buildwithnoknok/module-I2C-picohub-MOD-0011/hardware/MOD-0011-schematic.pdf

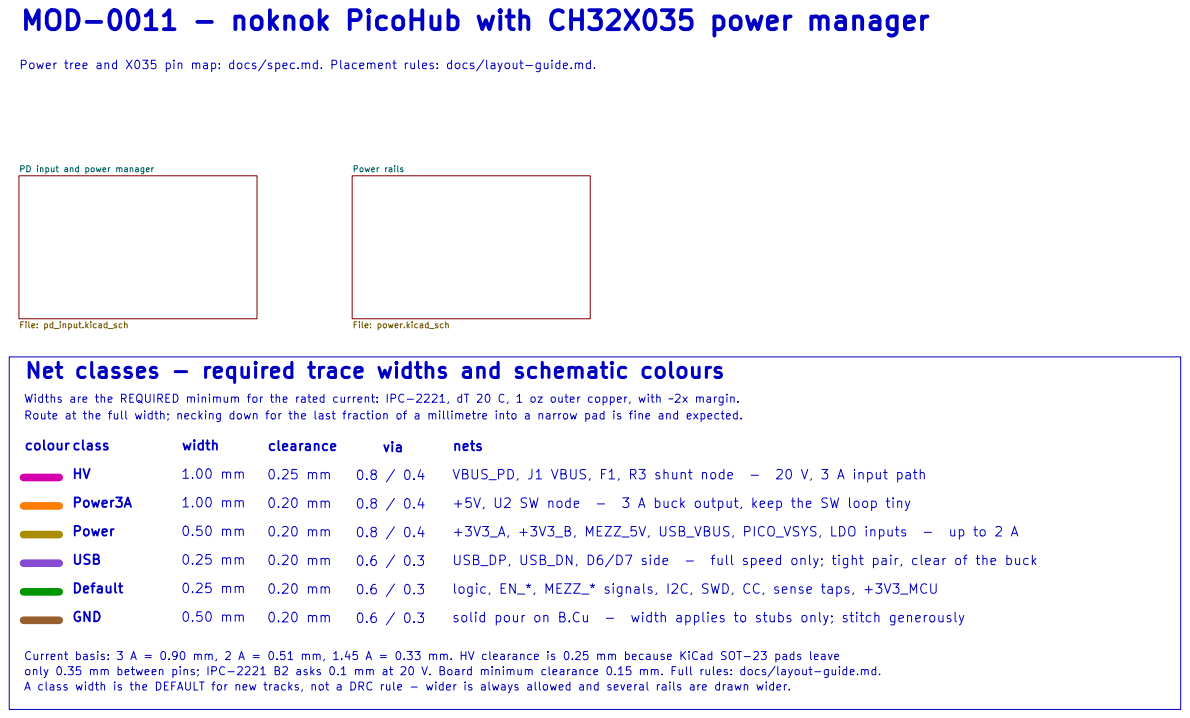
[picture p1: page 1]

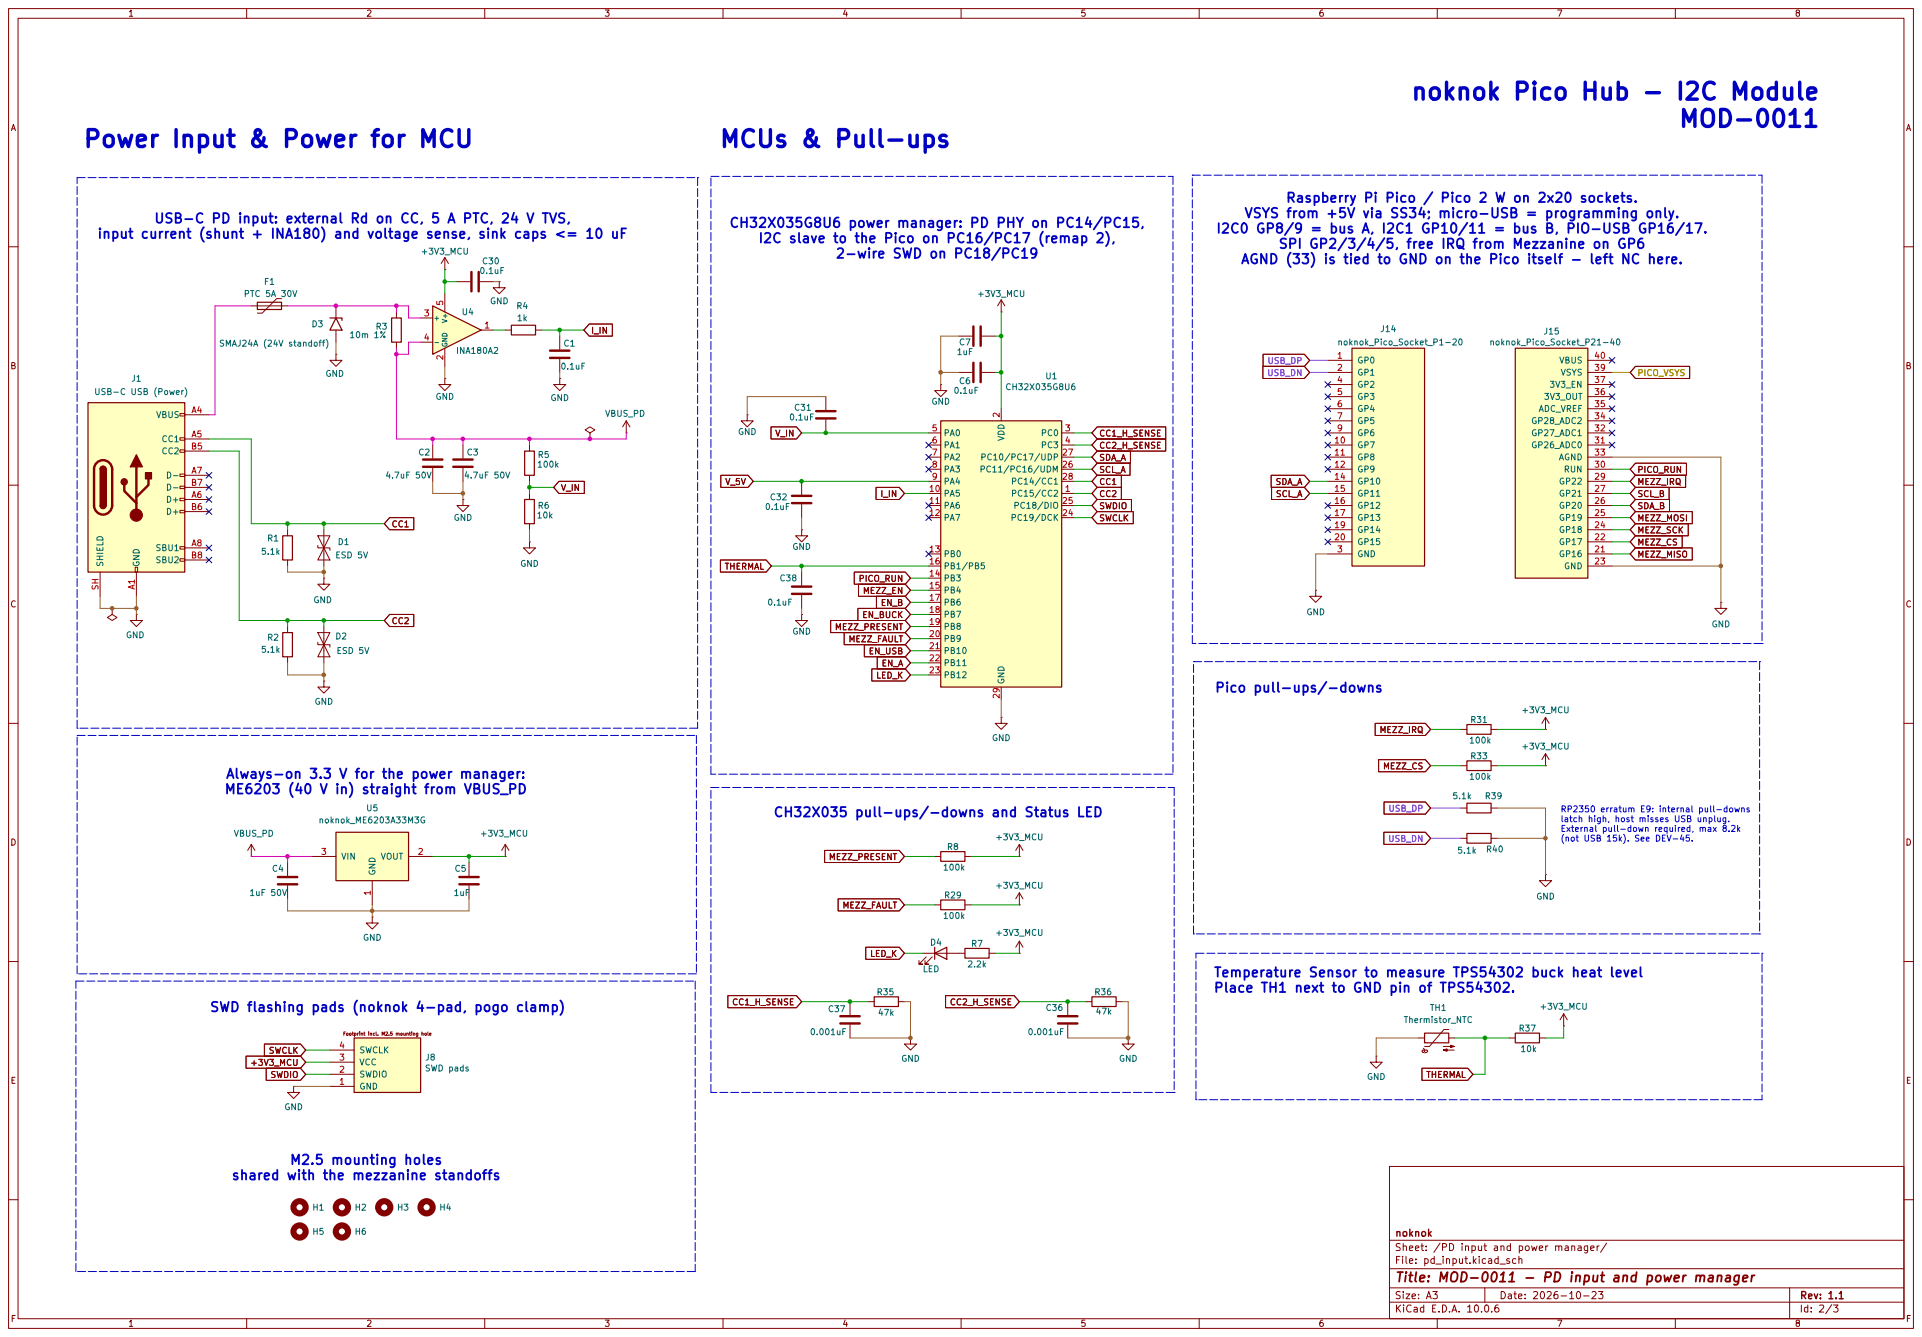
[picture p2: page 2]

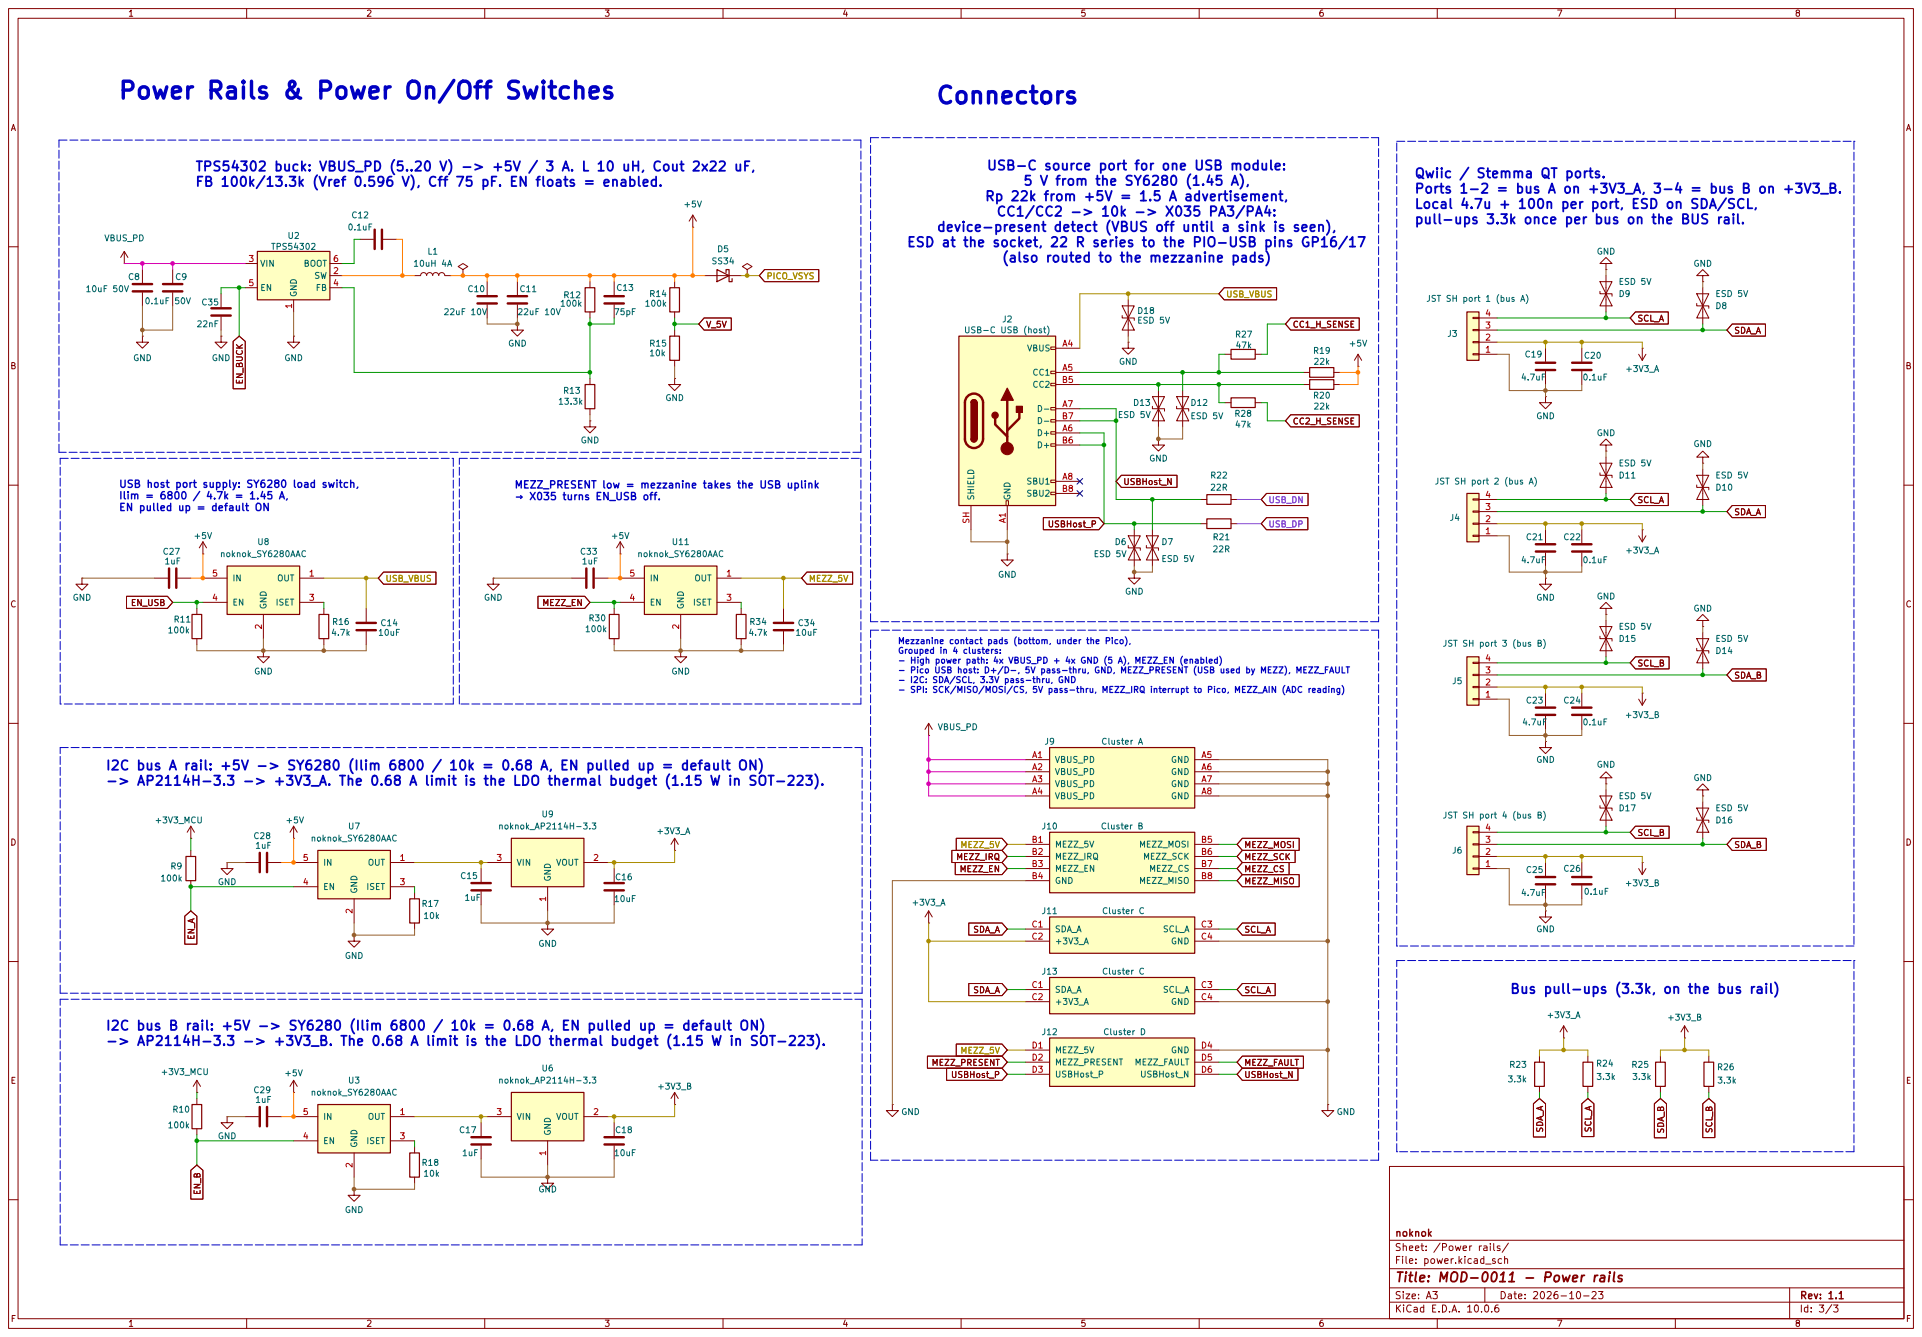
[picture p3: page 3]
