buildwithnoknok/module-I2C-picohub-MOD-0011/hardware/kicad/MOD-0011.kicad_pcb

## KiCad design hardware/kicad/MOD-0011.kicad_pcb (2026-10-23)

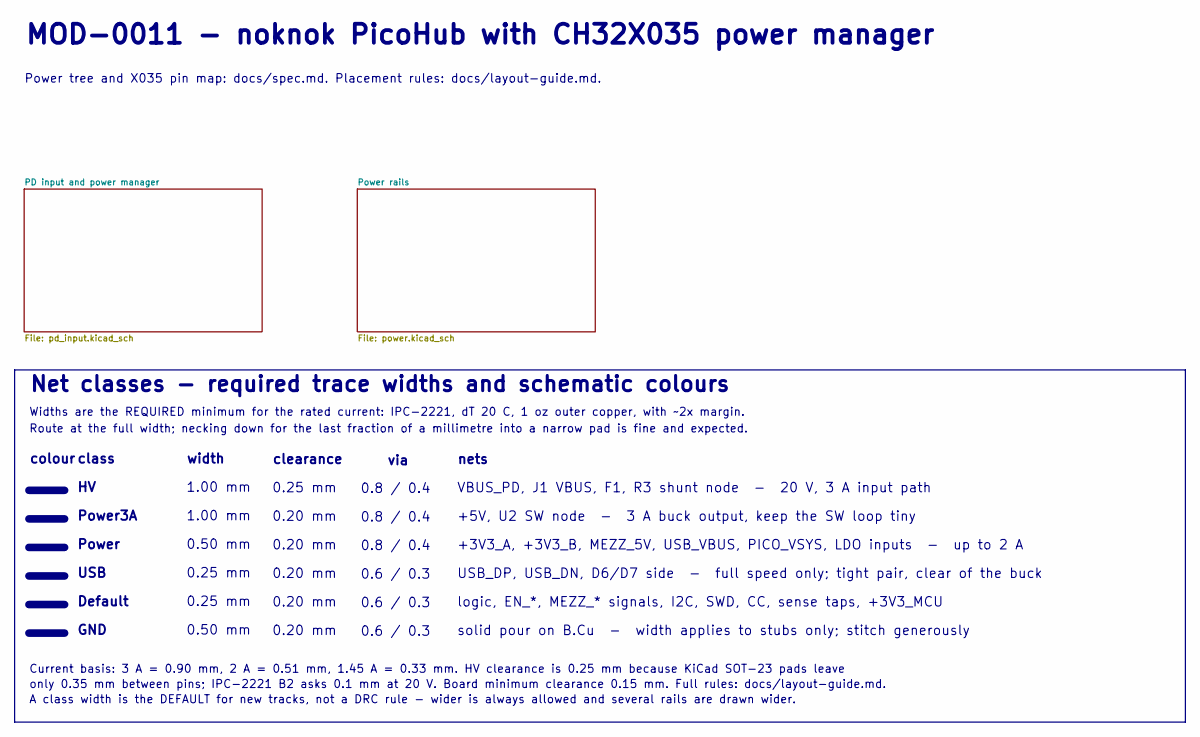
[picture p4: schematic MOD-0011.kicad_sch, MOD-0011 - noknok PicoHub]

Notes on the sheet:
Current basis: 3 A = 0.90 mm, 2 A = 0.51 mm, 1.45 A = 0.33 mm. HV clearance is 0.25 mm because KiCad SOT-23 pads leave
width
Power tree and X035 pin map: docs/spec.md. Placement rules: docs/layout-guide.md.
Net classes - required trace widths and schematic colours
USB
0.6 / 0.3
GND
USB_DP, USB_DN, D6/D7 side - full speed only; tight pair, clear of the buck
solid pour on B.Cu - width applies to stubs only; stitch generously
0.20 mm
class
+5V, U2 SW node - 3 A buck output, keep the SW loop tiny
1.00 mm
Default
A class width is the DEFAULT for new tracks, not a DRC rule - wider is always allowed and several rails are drawn wider.
VBUS_PD, J1 VBUS, F1, R3 shunt node - 20 V, 3 A input path
0.50 mm
0.25 mm
MOD-0011 - noknok PicoHub with CH32X035 power manager
clearance
via
+3V3_A, +3V3_B, MEZZ_5V, USB_VBUS, PICO_VSYS, LDO inputs - up to 2 A
0.8 / 0.4
colour
logic, EN_*, MEZZ_* signals, I2C, SWD, CC, sense taps, +3V3_MCU
Power3A
nets
only 0.35 mm between pins; IPC-2221 B2 asks 0.1 mm at 20 V. Board minimum clearance 0.15 mm. Full rules: docs/layout-guide.md.
Widths are the REQUIRED minimum for the rated current: IPC-2221, dT 20 C, 1 oz outer copper, with ~2x margin.
Power
Route at the full width; necking down for the last fraction of a millimetre into a narrow pad is fine and expected.

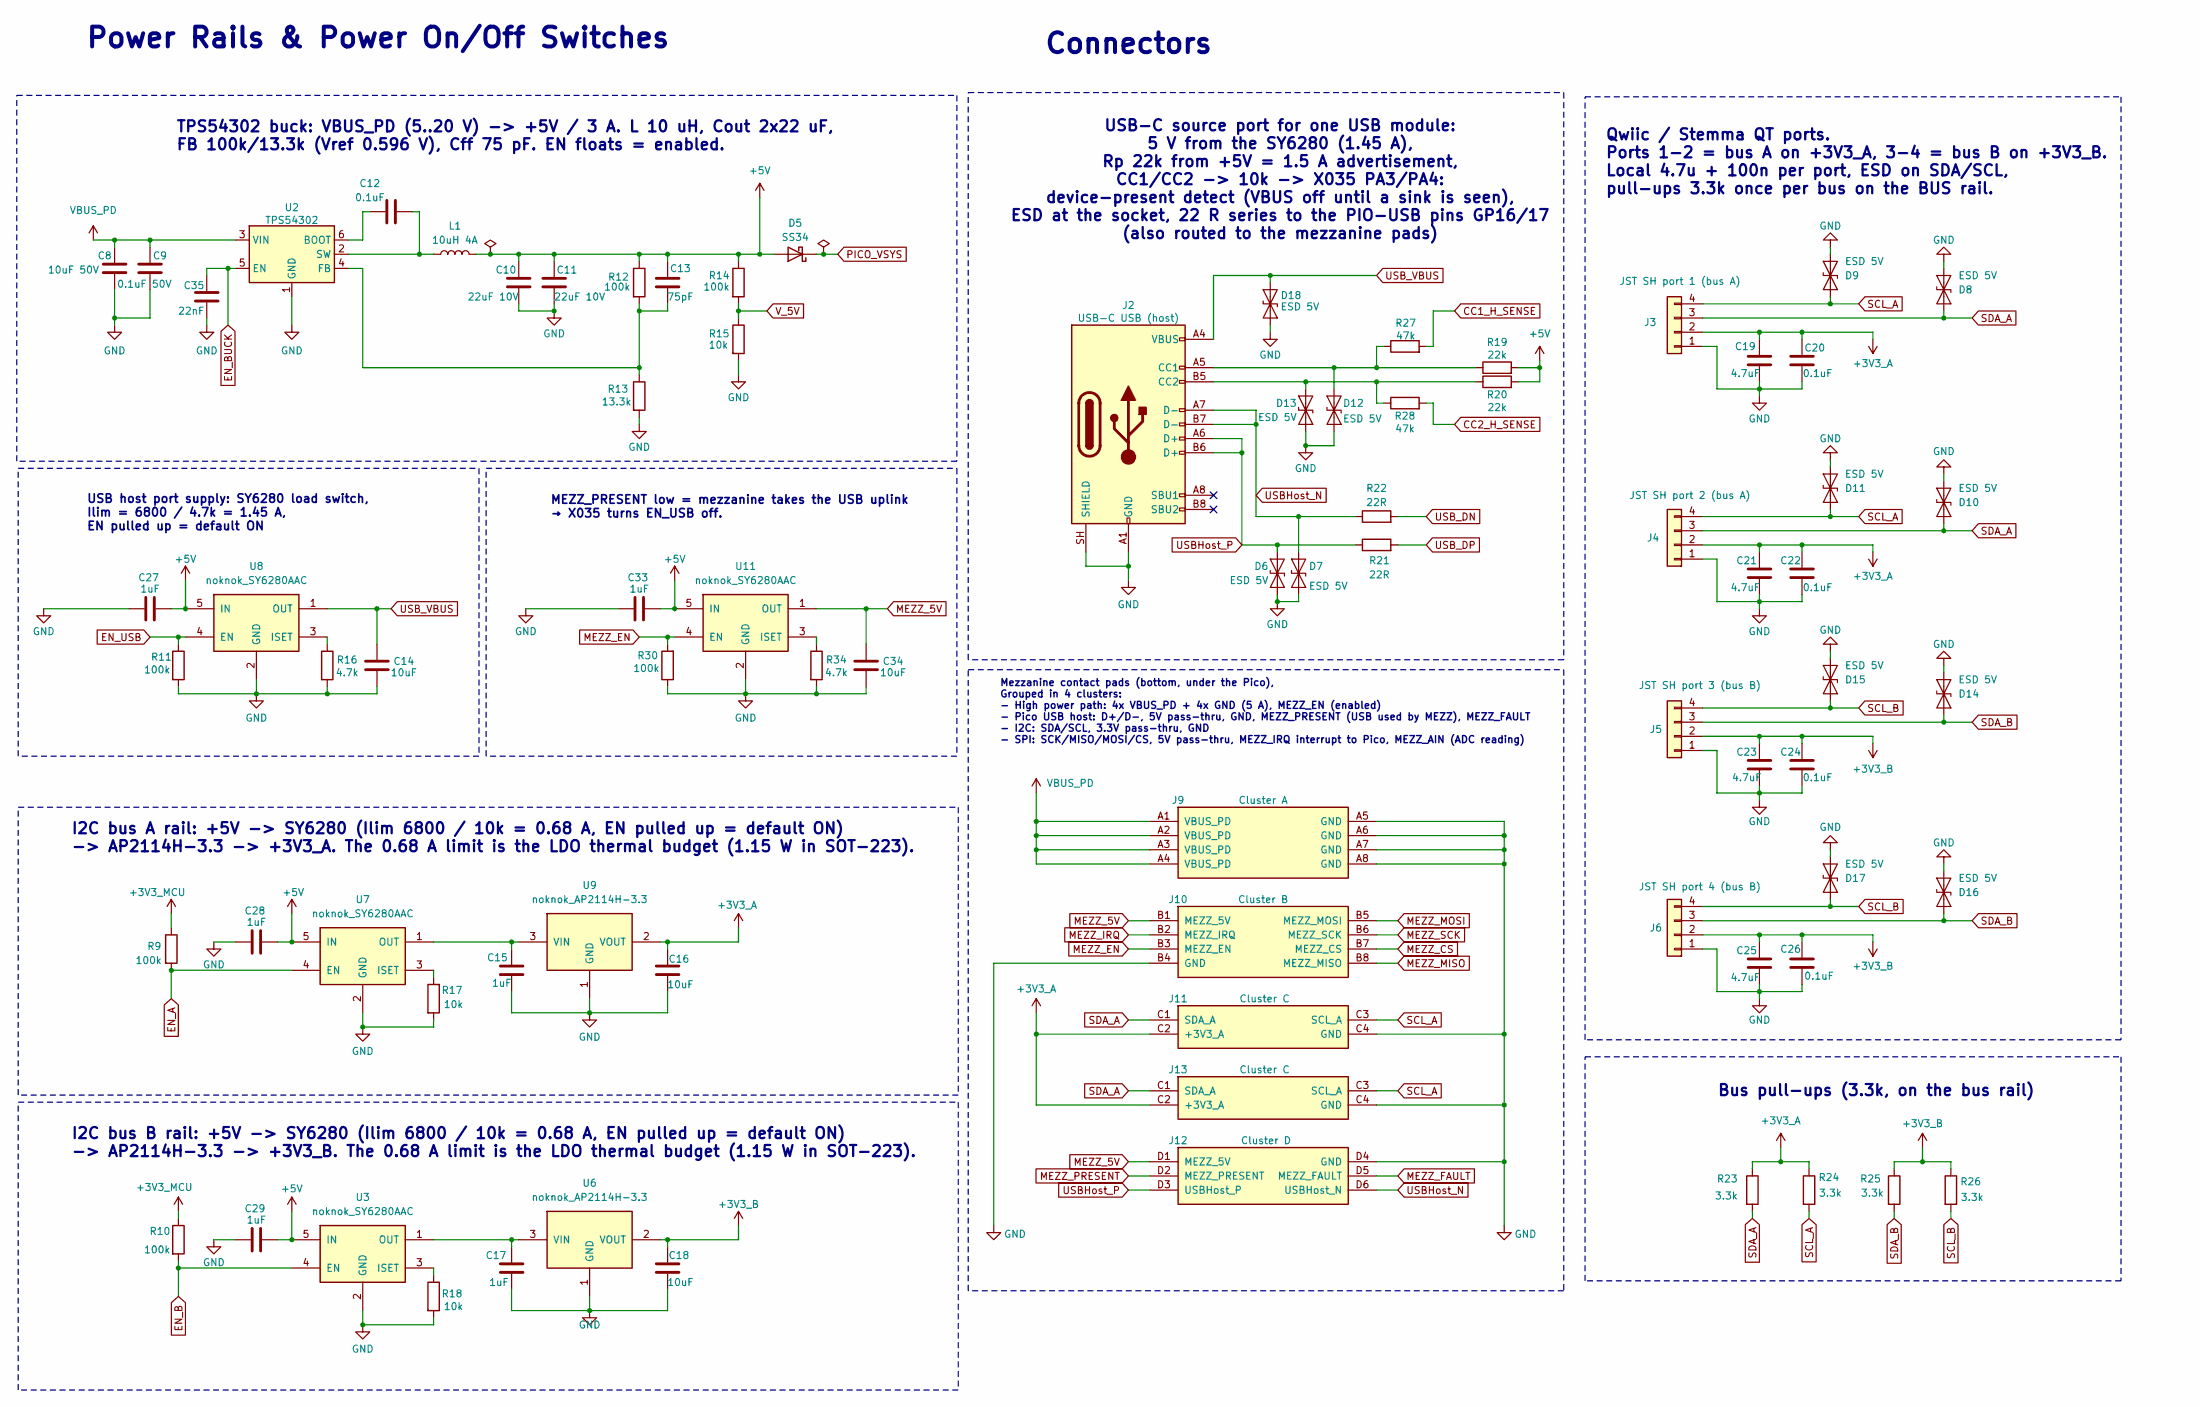
[picture p5: schematic power.kicad_sch, MOD-0011 - Power rails]

Parts:
C8: 10uF 50V; C_1210_3225Metric; LCSC Part # C138687
C9: 0.1uF 50V; C_0603_1608Metric; LCSC Part # C14663
C10, C11: 22uF 10V; C_0805_2012Metric; LCSC Part # C29277
C12, C20, C22, C24, C26: 0.1uF; C_0603_1608Metric; LCSC Part # C14663
C13: 75pF; C_0603_1608Metric; LCSC Part # C1681
C14, C16, C18, C34: 10uF; C_0805_2012Metric; LCSC Part # C15850
C15, C17, C27, C28, C29, C33: 1uF; C_0603_1608Metric; LCSC Part # C5199872
C19, C21, C23, C25: 4.7uF; C_0805_2012Metric; LCSC Part # C1779
C35: 22nF; C_0603_1608Metric; LCSC Part # C21122
D5: SS34; D_SMA; LCSC Part # C8678
D6, D7, D8, D9, D10, D11, D12, D13, D14, D15, D16, D17, D18: ESD 5V; D_SOD-923; LCSC Part # C111566
J2: USB-C USB (host); USB_C_Receptacle_HRO_TYPE-C-31-M-12; LCSC Part # C165948
J3: JST SH port 1 (bus A); JST_SH_SM04B-SRSS-TB_1x04-1MP_P1.00mm_Horizontal; LCSC Part # C160404
J4: JST SH port 2 (bus A); JST_SH_SM04B-SRSS-TB_1x04-1MP_P1.00mm_Horizontal; LCSC Part # C160404
J5: JST SH port 3 (bus B); JST_SH_SM04B-SRSS-TB_1x04-1MP_P1.00mm_Horizontal; LCSC Part # C160404
J6: JST SH port 4 (bus B); JST_SH_SM04B-SRSS-TB_1x04-1MP_P1.00mm_Horizontal; LCSC Part # C160404
J9: Cluster A; noknok_Mezzanine_A_Pads_M2.5
J10: Cluster B; noknok_Mezzanine_B_Pads_M2.5
J11, J13: Cluster C; noknok_Mezzanine_C_Pads_M2.5
J12: Cluster D; noknok_Mezzanine_D_Pads_M2.5
L1: 10uH 4A; L_Chilisin_BMRx00060630; LCSC Part # C2981193
R9, R10, R11, R12, R14, R30: 100k; R_0603_1608Metric; LCSC Part # C25803
R13: 13.3k; R_0603_1608Metric; LCSC Part # C25952
R15, R17, R18: 10k; R_0603_1608Metric; LCSC Part # C25804
R16, R34: 4.7k; R_0603_1608Metric; LCSC Part # C23162
R19, R20: 22k; R_0603_1608Metric; LCSC Part # C31850
R21, R22: 22R; R_0603_1608Metric; LCSC Part # C23345
R23, R24, R25, R26: 3.3k; R_0603_1608Metric; LCSC Part # C22978
R27, R28: 47k; R_0603_1608Metric; LCSC Part # C25819
U2: TPS54302; TSOT-23-6; LCSC Part # C311983
U3, U7, U8, U11: noknok_SY6280AAC; SOT-23-5; LCSC Part # C55136
U6, U9: noknok_AP2114H-3.3; SOT-223-3_TabPin2; LCSC Part # C150716

Connections:
+3V3_A: C16.1, C19.1, C20.1, C21.1, C22.1, J3.2, J4.2, J11.C2 (+3V3_A), J13.C2 (+3V3_A), R23.1, R24.1, U9.2 (VOUT)
+3V3_B: C18.1, C23.1, C24.1, C25.1, C26.1, J5.2, J6.2, R25.1, R26.1, U6.2 (VOUT)
+3V3_MCU: R9.1, R10.1; also elsewhere on the board
CC1_H_SENSE: R27.2; also elsewhere on the board
CC2_H_SENSE: R28.2; also elsewhere on the board
EN_A: R9.2, U7.4 (EN); also elsewhere on the board
EN_B: R10.2, U3.4 (EN); also elsewhere on the board
EN_BUCK: C35.1, U2.5 (EN); also elsewhere on the board
EN_USB: R11.1, U8.4 (EN); also elsewhere on the board
MEZZ_5V: C34.2, J10.B1 (MEZZ_5V), J12.D1 (MEZZ_5V), U11.1 (OUT)
MEZZ_CS: J10.B7 (MEZZ_CS); also elsewhere on the board
MEZZ_EN: J10.B3 (MEZZ_EN), R30.2, U11.4 (EN); also elsewhere on the board
MEZZ_FAULT: J12.D5 (MEZZ_FAULT); also elsewhere on the board
MEZZ_IRQ: J10.B2 (MEZZ_IRQ); also elsewhere on the board
MEZZ_MISO: J10.B8 (MEZZ_MISO); also elsewhere on the board
MEZZ_MOSI: J10.B5 (MEZZ_MOSI); also elsewhere on the board
MEZZ_PRESENT: J12.D2 (MEZZ_PRESENT); also elsewhere on the board
MEZZ_SCK: J10.B6 (MEZZ_SCK); also elsewhere on the board
unnamed: D12.1 (A1), J2.A5 (CC1), R19.1, R27.1
unnamed: D13.1 (A1), J2.B5 (CC2), R20.1, R28.1
unnamed: C12.1, U2.6 (BOOT)
unnamed: C13.2, R12.2, R13.1, U2.4 (FB)
unnamed: C12.2, L1.1, U2.2 (SW)
unnamed: R18.1, U3.3 (ISET)
unnamed: C17.1, U3.1 (OUT), U6.3 (VIN)
unnamed: R17.1, U7.3 (ISET)
unnamed: C15.1, U7.1 (OUT), U9.3 (VIN)
unnamed: R16.1, U8.3 (ISET)
unnamed: R34.1, U11.3 (ISET)
SCL_A: D9.1 (A1), D11.1 (A1), J3.4, J4.4, J11.C3 (SCL_A), J13.C3 (SCL_A), R24.2; also elsewhere on the board
SCL_B: D15.1 (A1), D17.1 (A1), J5.4, J6.4, R26.2; also elsewhere on the board
SDA_A: D8.1 (A1), D10.1 (A1), J3.3, J4.3, J11.C1 (SDA_A), J13.C1 (SDA_A), R23.2; also elsewhere on the board
SDA_B: D14.1 (A1), D16.1 (A1), J5.3, J6.3, R25.2; also elsewhere on the board
USBHost_N: D7.1 (A1), J2.A7 (D-), J2.B7 (D-), J12.D6 (USBHost_N), R22.1
USBHost_P: D6.1 (A1), J2.A6 (D+), J2.B6 (D+), J12.D3 (USBHost_P), R21.1
USB_DN: R22.2; also elsewhere on the board
USB_DP: R21.2; also elsewhere on the board
USB_VBUS: C14.2, D18.1 (A1), J2.A4 (VBUS), J2.A9 (VBUS), J2.B4 (VBUS), J2.B9 (VBUS), U8.1 (OUT)
V_5V: R14.2, R15.1; also elsewhere on the board

Notes on the sheet:
Connectors
TPS54302 buck: VBUS_PD (5..20 V) -> +5V / 3 A. L 10 uH, Cout 2x22 uF, FB 100k/13.3k (Vref 0.596 V), Cff 75 pF. EN floats = enabled.
Qwiic / Stemma QT ports. Ports 1-2 = bus A on +3V3_A, 3-4 = bus B on +3V3_B. Local 4.7u + 100n per port, ESD on SDA/SCL, pull-ups 3.3k once per bus on the BUS rail.
I2C bus A rail: +5V -> SY6280 (Ilim 6800 / 10k = 0.68 A, EN pulled up = default ON) -> AP2114H-3.3 -> +3V3_A. The 0.68 A limit is the LDO thermal budget (1.15 W in SOT-223).
USB-C source port for one USB module: 5 V from the SY6280 (1.45 A), Rp 22k from +5V = 1.5 A advertisement, CC1/CC2 -> 10k -> X035 PA3/PA4: device-present detect (VBUS off until a sink is seen), ESD at the socket, 22 R series to the PIO-USB pins GP16/17 (also routed to the mezzanine pads)
USB host port supply: SY6280 load switch, Ilim = 6800 / 4.7k = 1.45 A, EN pulled up = default ON
Power Rails & Power On/Off Switches
Bus pull-ups (3.3k, on the bus rail)
MEZZ_PRESENT low = mezzanine takes the USB uplink → X035 turns EN_USB off.
Mezzanine contact pads (bottom, under the Pico), Grouped in 4 clusters: - High power path: 4x VBUS_PD + 4x GND (5 A), MEZZ_EN (enabled) - Pico USB host: D+/D-, 5V pass-thru, GND, MEZZ_PRESENT (USB used by MEZZ), MEZZ_FAULT - I2C: SDA/SCL, 3.3V pass-thru, GND - SPI: SCK/MISO/MOSI/CS, 5V pass-thru, M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
I2C bus B rail: +5V -> SY6280 (Ilim 6800 / 10k = 0.68 A, EN pulled up = default ON) -> AP2114H-3.3 -> +3V3_B. The 0.68 A limit is the LDO thermal budget (1.15 W in SOT-223).

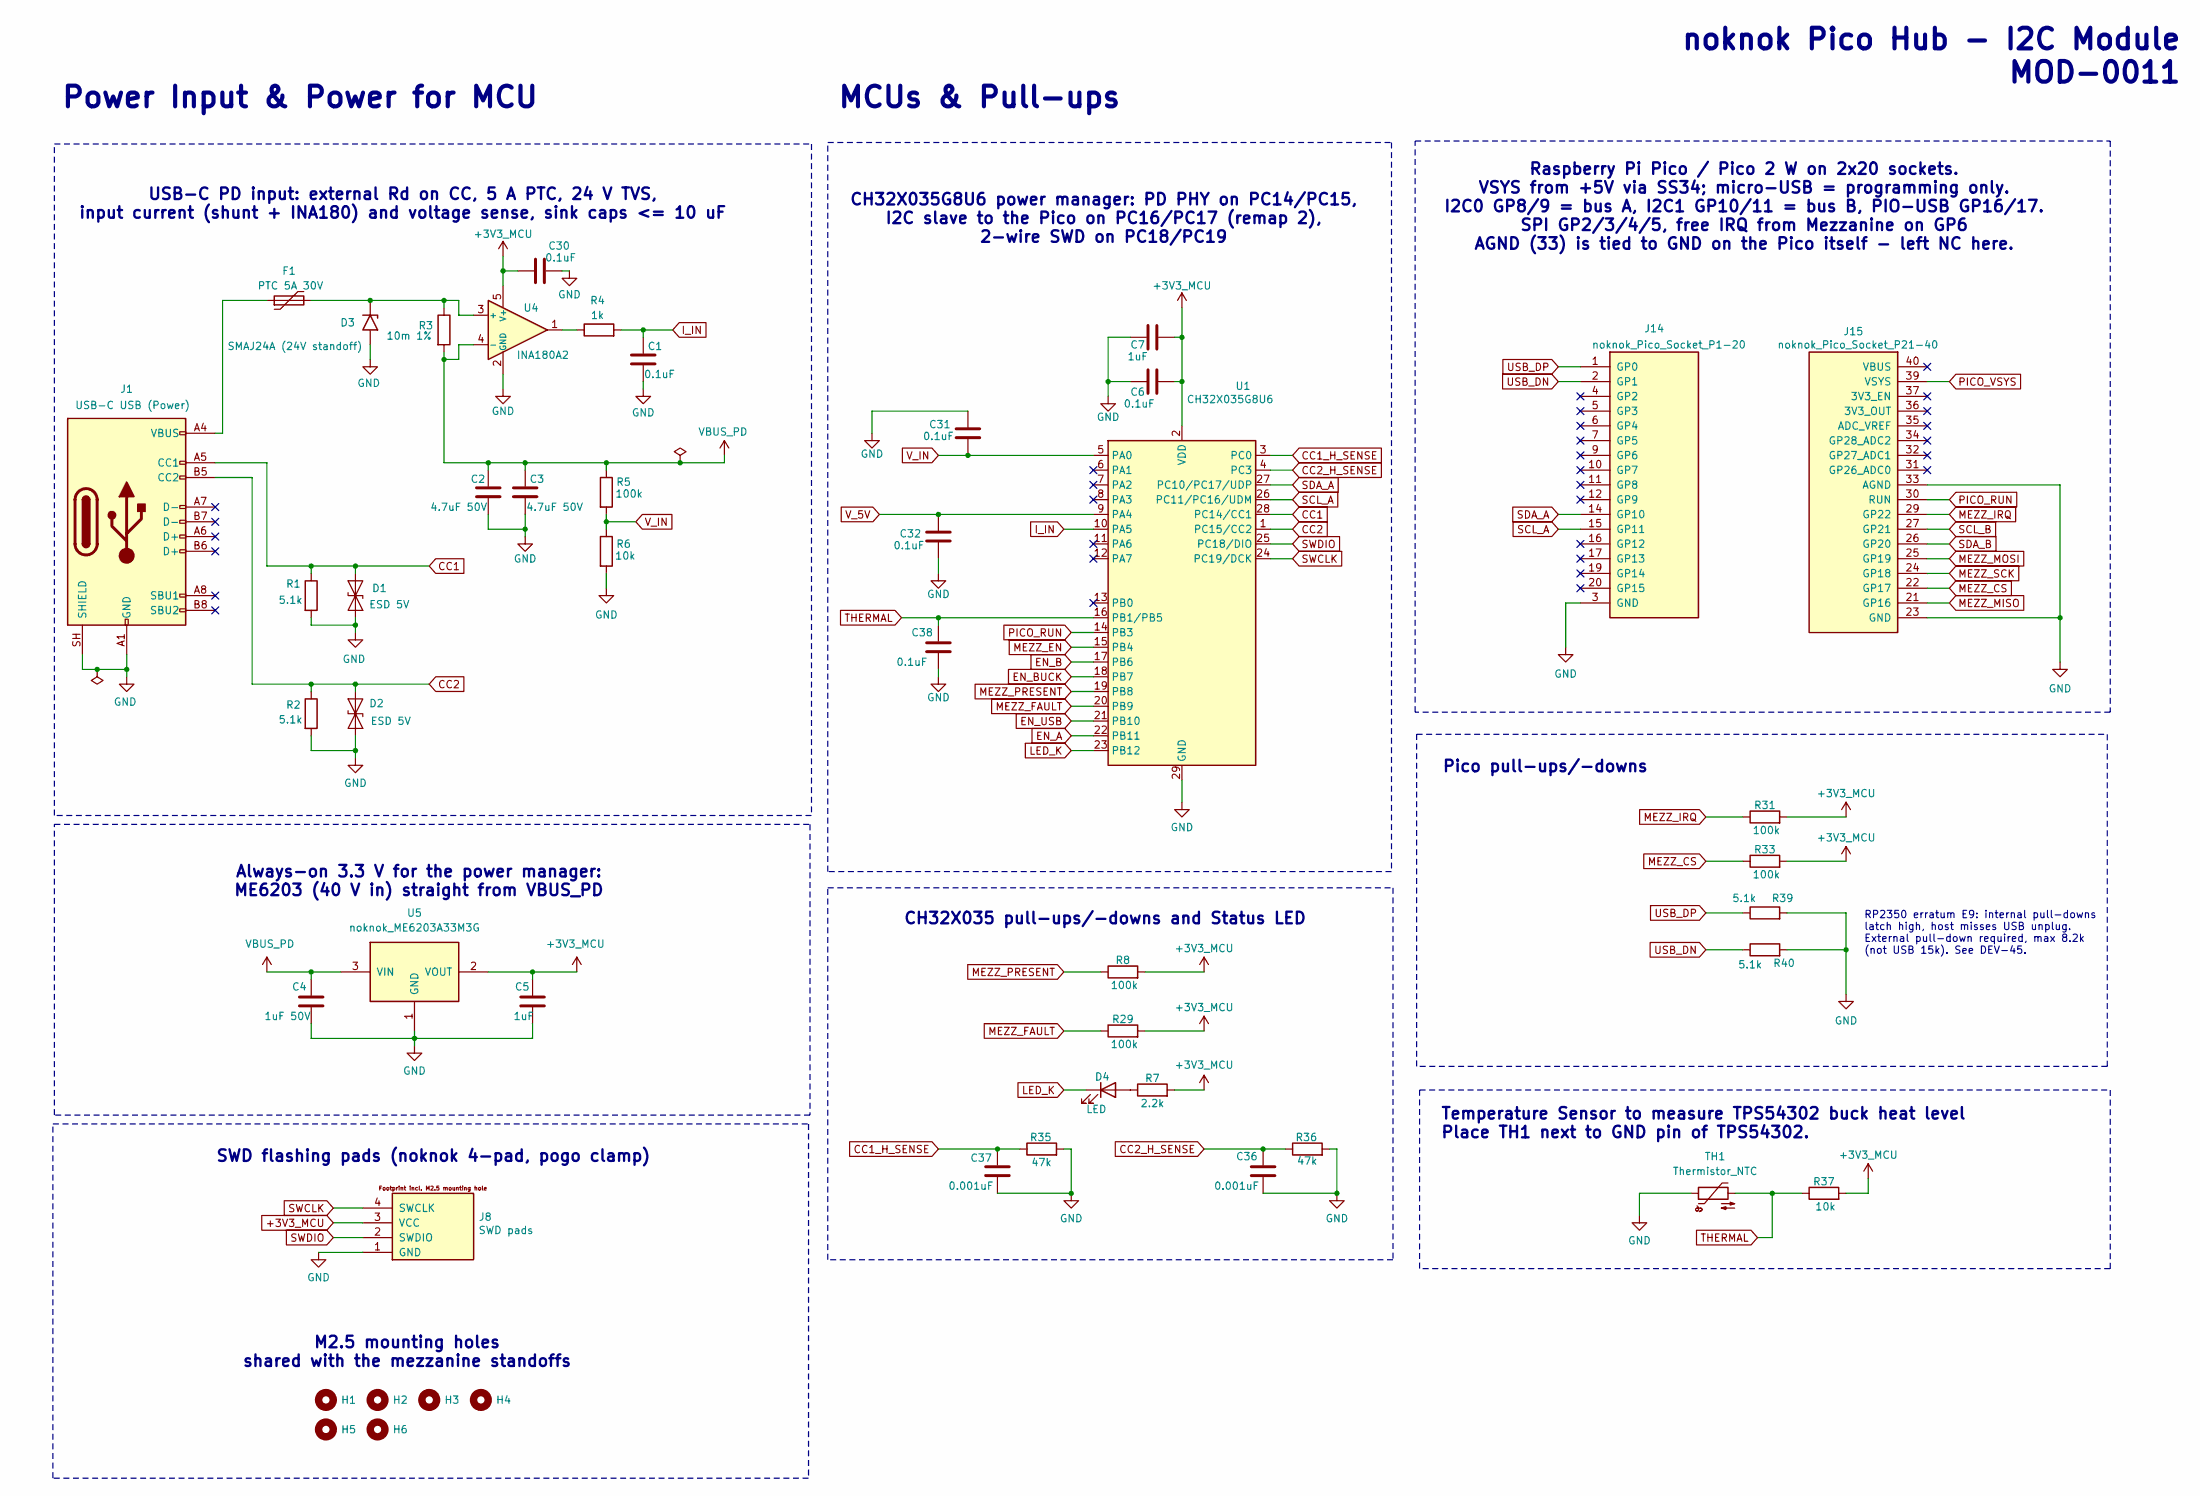
[picture p6: schematic pd_input.kicad_sch, MOD-0011 - PD input and power manager]

Parts:
C1, C6, C30, C31, C32, C38: 0.1uF; C_0603_1608Metric; LCSC Part # C14663
C2, C3: 4.7uF 50V; C_1206_3216Metric; LCSC Part # C51205
C4: 1uF 50V; C_0603_1608Metric; LCSC Part # C5199872
C5, C7: 1uF; C_0603_1608Metric; LCSC Part # C5199872
C36, C37: 0.001uF; C_0603_1608Metric; LCSC Part # C1588
D1, D2: ESD 5V; D_SOD-923; LCSC Part # C111566
D3: SMAJ24A (24V standoff); D_SMA; LCSC Part # C908774
D4: LED; LED_0603_1608Metric; LCSC Part # C2286
F1: PTC 5A 30V; Fuse_2920_7451Metric; LCSC Part # C19078763
H1, H2, H3, H4, H5, H6: noknok_MountingHole; noknok_MountingHole_2.5mm_M2.5
J1: USB-C USB (Power); USB_C_Receptacle_HRO_TYPE-C-31-M-12; LCSC Part # C165948
J8: SWD pads; noknok_FlashPads_USB-module_1x4_M2.5
J14: noknok_Pico_Socket_P1-20; noknok_Pico_Socket_P1-20_THT; LCSC Part # C7509519
J15: noknok_Pico_Socket_P21-40; noknok_Pico_Socket_P21-40_THT; LCSC Part # C7509519
R1, R2: 5.1k; R_0603_1608Metric; LCSC Part # C23186
R3: 10m 1%; R_2512_6332Metric; LCSC Part # C46634450
R4: 1k; R_0603_1608Metric; LCSC Part # C21190
R5, R8, R29, R31, R33: 100k; R_0603_1608Metric; LCSC Part # C25803
R6, R37: 10k; R_0603_1608Metric; LCSC Part # C25804
R7: 2.2k; R_0603_1608Metric; LCSC Part # C4190
R35, R36: 47k; R_0603_1608Metric; LCSC Part # C25819
R39, R40: 5.1k; R_0603_1608Metric; LCSC Part # C21190
TH1: Thermistor_NTC; R_0603_1608Metric; LCSC Part # C2892547
U1: CH32X035G8U6; WQFN-28-1EP_4x4mm_P0.4mm_EP2.7x2.7mm; LCSC Part # C7437027
U4: INA180A2; SOT-23-5; LCSC Part # C192764
U5: noknok_ME6203A33M3G; SOT-23; LCSC Part # C87842

Connections:
+3V3_MCU: C5.1, C6.2, C7.2, C30.1, J8.3 (VCC), R7.2, R8.2, R29.2, R31.2, R33.2, R37.2, U1.2 (VDD), U4.5 (V+), U5.2 (VOUT); also elsewhere on the board
CC1: D1.1 (A1), J1.A5 (CC1), R1.1, U1.28 (PC14/CC1)
CC1_H_SENSE: C37.1, R35.1, U1.3 (PC0); also elsewhere on the board
CC2: D2.1 (A1), J1.B5 (CC2), R2.1, U1.1 (PC15/CC2)
CC2_H_SENSE: C36.1, R36.1, U1.4 (PC3); also elsewhere on the board
EN_A: U1.22 (PB11); also elsewhere on the board
EN_B: U1.17 (PB6); also elsewhere on the board
EN_BUCK: U1.18 (PB7); also elsewhere on the board
EN_USB: U1.21 (PB10); also elsewhere on the board
I_IN: C1.1, R4.2, U1.10 (PA5)
LED_K: D4.1 (K), U1.23 (PB12)
MEZZ_CS: J15.22 (GP17), R33.1; also elsewhere on the board
MEZZ_EN: U1.15 (PB4); also elsewhere on the board
MEZZ_FAULT: R29.1, U1.20 (PB9); also elsewhere on the board
MEZZ_IRQ: J15.29 (GP22), R31.1; also elsewhere on the board
MEZZ_MISO: J15.21 (GP16); also elsewhere on the board
MEZZ_MOSI: J15.25 (GP19); also elsewhere on the board
MEZZ_PRESENT: R8.1, U1.19 (PB8); also elsewhere on the board
MEZZ_SCK: J15.24 (GP18); also elsewhere on the board
unnamed: D3.1 (A1), F1.2, R3.1, U4.3 (+)
unnamed: D4.2 (A), R7.1
unnamed: F1.1, J1.A4 (VBUS), J1.A9 (VBUS), J1.B4 (VBUS), J1.B9 (VBUS)
unnamed: R4.1, U4.1
PICO_RUN: J15.30 (RUN), U1.14 (PB3)
SCL_A: J14.15 (GP11), U1.26 (PC11/PC16/UDM); also elsewhere on the board
SCL_B: J15.27 (GP21); also elsewhere on the board
SDA_A: J14.14 (GP10), U1.27 (PC10/PC17/UDP); also elsewhere on the board
SDA_B: J15.26 (GP20); also elsewhere on the board
SWCLK: J8.4 (SWCLK), U1.24 (PC19/DCK)
SWDIO: J8.2 (SWDIO), U1.25 (PC18/DIO)
THERMAL: C38.1, R37.1, TH1.2, U1.16 (PB1/PB5)
USB_DN: J14.2 (GP1), R40.1; also elsewhere on the board
USB_DP: J14.1 (GP0), R39.1; also elsewhere on the board
V_5V: C32.2, U1.9 (PA4); also elsewhere on the board
V_IN: C31.1, R5.2, R6.1, U1.5 (PA0)

Notes on the sheet:
RP2350 erratum E9: internal pull-downs latch high, host misses USB unplug. External pull-down required, max 8.2k (not USB 15k). See DEV-45.
Temperature Sensor to measure TPS54302 buck heat level Place TH1 next to GND pin of TPS54302.
Power Input & Power for MCU
Pico pull-ups/-downs
SWD flashing pads (noknok 4-pad, pogo clamp)
CH32X035G8U6 power manager: PD PHY on PC14/PC15, I2C slave to the Pico on PC16/PC17 (remap 2), 2-wire SWD on PC18/PC19
Raspberry Pi Pico / Pico 2 W on 2x20 sockets. VSYS from +5V via SS34; micro-USB = programming only. I2C0 GP8/9 = bus A, I2C1 GP10/11 = bus B, PIO-USB GP16/17. SPI GP2/3/4/5, free IRQ from Mezzanine on GP6 AGND (33) is tied to GND on the Pico itself - left NC here.
MCUs & Pull-ups
USB-C PD input: external Rd on CC, 5 A PTC, 24 V TVS, input current (shunt + INA180) and voltage sense, sink caps <= 10 uF
M2.5 mounting holes shared with the mezzanine standoffs
CH32X035 pull-ups/-downs and Status LED
Always-on 3.3 V for the power manager: ME6203 (40 V in) straight from VBUS_PD
noknok Pico Hub - I2C Module MOD-0011

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
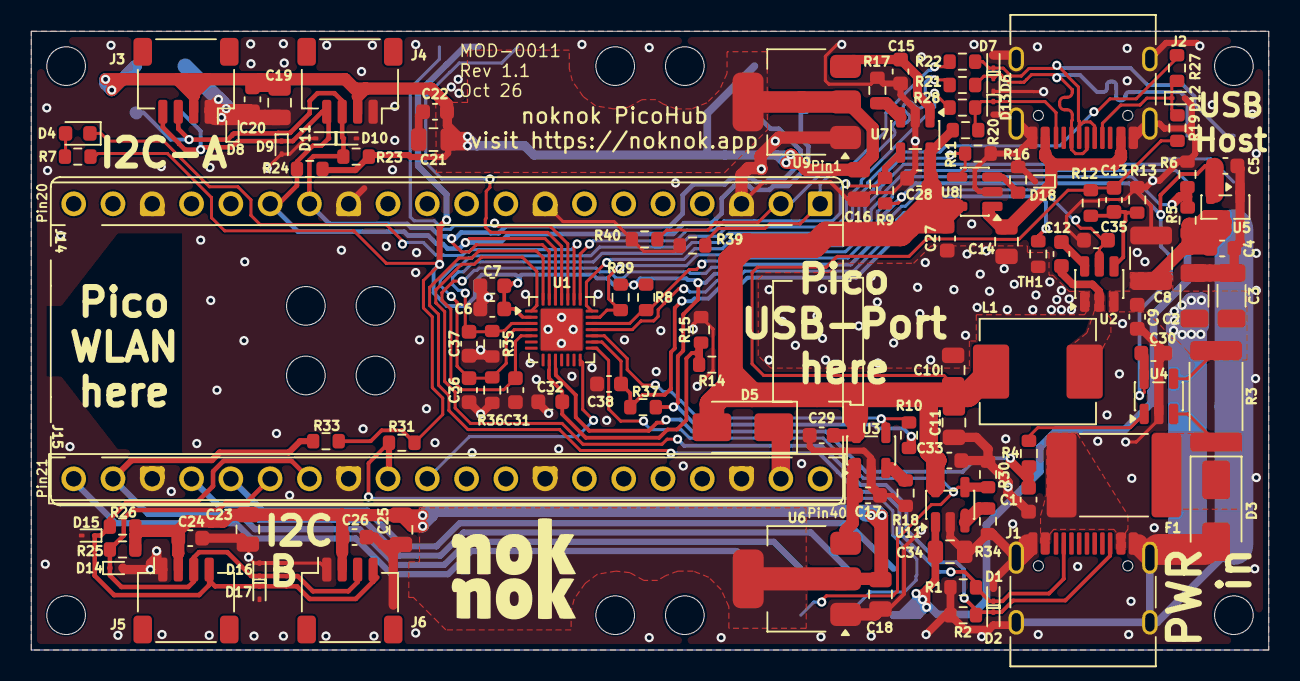
[picture p7: board MOD-0011.kicad_pcb from above]

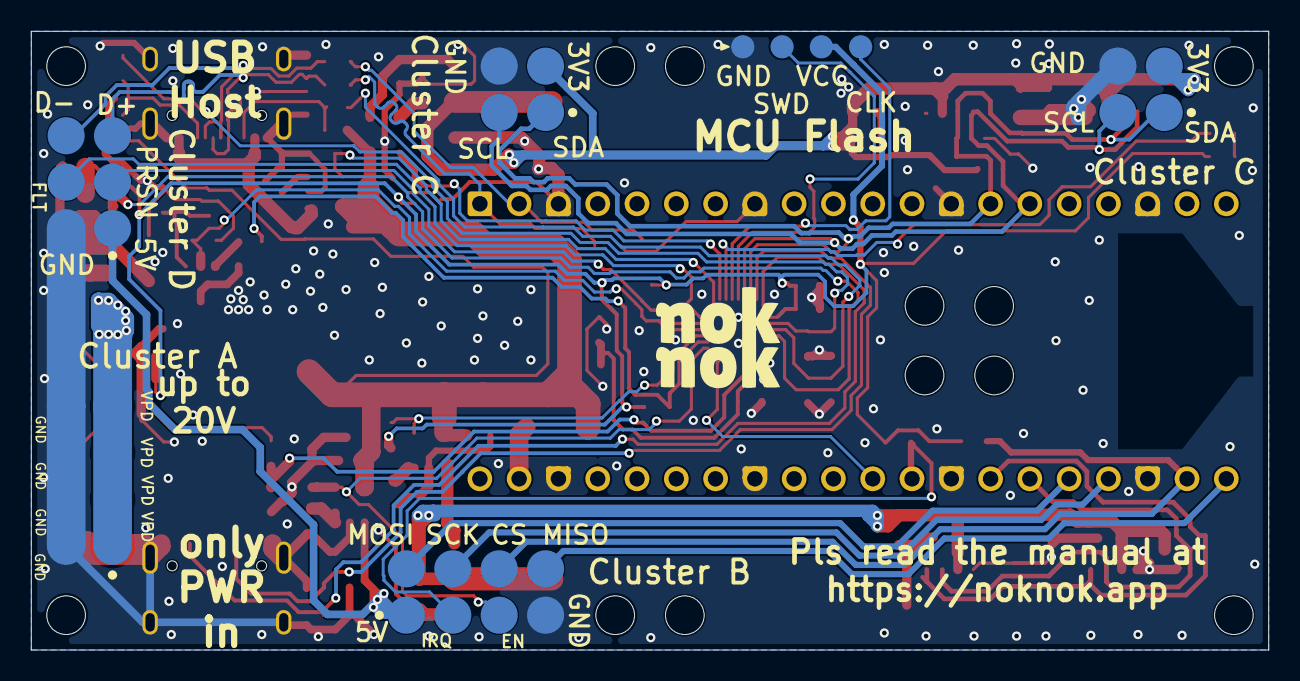
[picture p8: board MOD-0011.kicad_pcb from below]

Board: 2 copper layers, 80.0 x 40.0 mm, 127 parts (6 on the bottom side), 56 nets.
