buildwithnoknok/module-I2C-picohub-MOD-0011/(commit log)

2026-10-19 noknok PicoHub (MOD-0011): hardware rev 1.0 (KiCad, schematic, BOM), specification, power-manager firmware 0.2.0
    [MOD-0011-bom.csv, MOD-0011.kicad_pcb, MOD-0011.kicad_sch, pd_input.kicad_sch, power.kicad_sch]
2026-10-19 DEV-124: power manager 0.3.0 - field update over I2C (noknok bootloader, layout 3) 0xB0 enters the bootloader; app header NKA1/X035/layout 3; boot-attempt counter cleared when the brain reaches the a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
2026-10-22 DEV-117: thermal logger for bring-up step 6 (holds 20 V, logs NTC/V_IN/I_IN/V_5V every 10 s)
2026-10-22 DEV-125: MOD-0011 power manager test plan with the Proof-of-Concept safety gate (status per item, open items in DEV-143..146)
2026-10-23 DEV-45: rev 1.1 - R39/R40 5.1k pull-downs on USB_DP/USB_DN at the Pico (RP2350 erratum E9), schematic note, layout (D16/D17 shifted 1.75 mm), BOM line 20 now R1,R2,R39,R40 x4 (C23186)
    ERC 0. DRC: the 12 known board-edge items only, 0 unconnected, schematic parity 0.
    BOM cross-checked against the schematic: 115 parts each.
    [MOD-0011-bom.csv, MOD-0011.kicad_pcb, pd_input.kicad_sch]
2026-10-23 MOD-0011 rev 1.1 labels: silkscreen "Rev 1.1 / Oct 26", schematic title block rev 1.1 (2026-10-23), schematic PDF re-exported
    ERC 0. DRC: the 12 known board-edge items only, 0 unconnected, schematic parity 0. No parts or tracks changed.
    [MOD-0011.kicad_pcb, MOD-0011.kicad_sch]
2026-10-23 MOD-0011 rev 1.1: title block rev 1.1 (2026-10-23) on the pd_input and power sheets too, schematic PDF re-exported. ERC 0.
    [pd_input.kicad_sch, power.kicad_sch]
2026-10-29 DEV-171: housing profile for the housing configurator (from rev 1.0 PCB)
2026-10-29 DEV-171: housing profile clearance_top 18 mm (Pico debug connector)
2026-11-05 firmware 0.3.1 (DEV-195): cold start - leave a self-started 5 V buck on instead of switching it off for the PD hold (no more double power-up of the modules)
